xiyu0826/FaceAccess/hardware/原理图/01-全板原理图.png

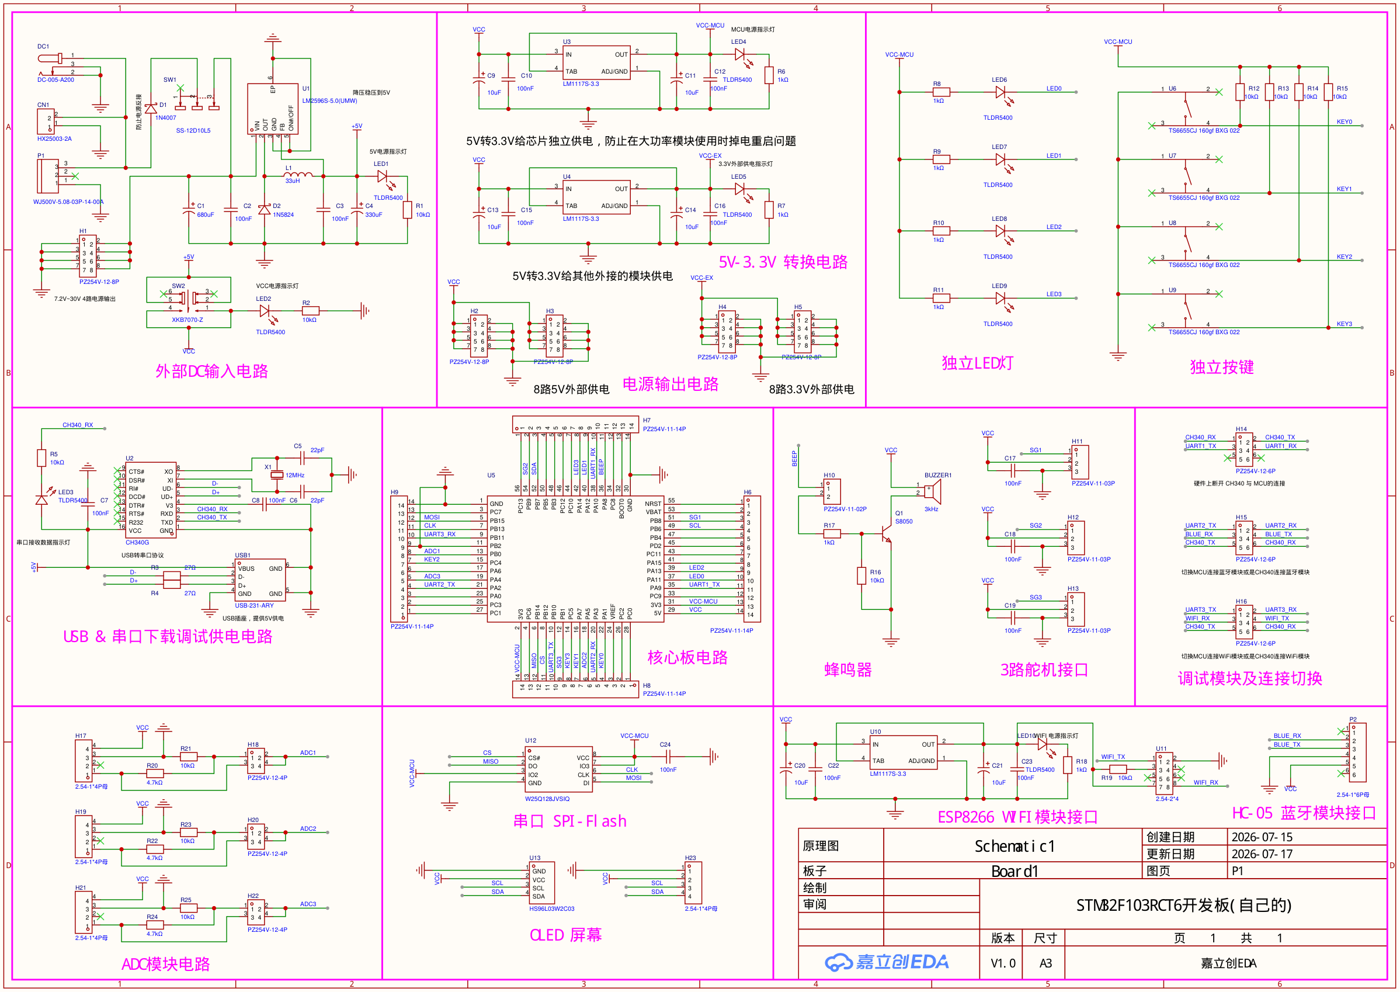
hardware/原理图/01-全板原理图.png
