xiyu0826/FaceAccess/hardware/原理图/02-核心板电路.png

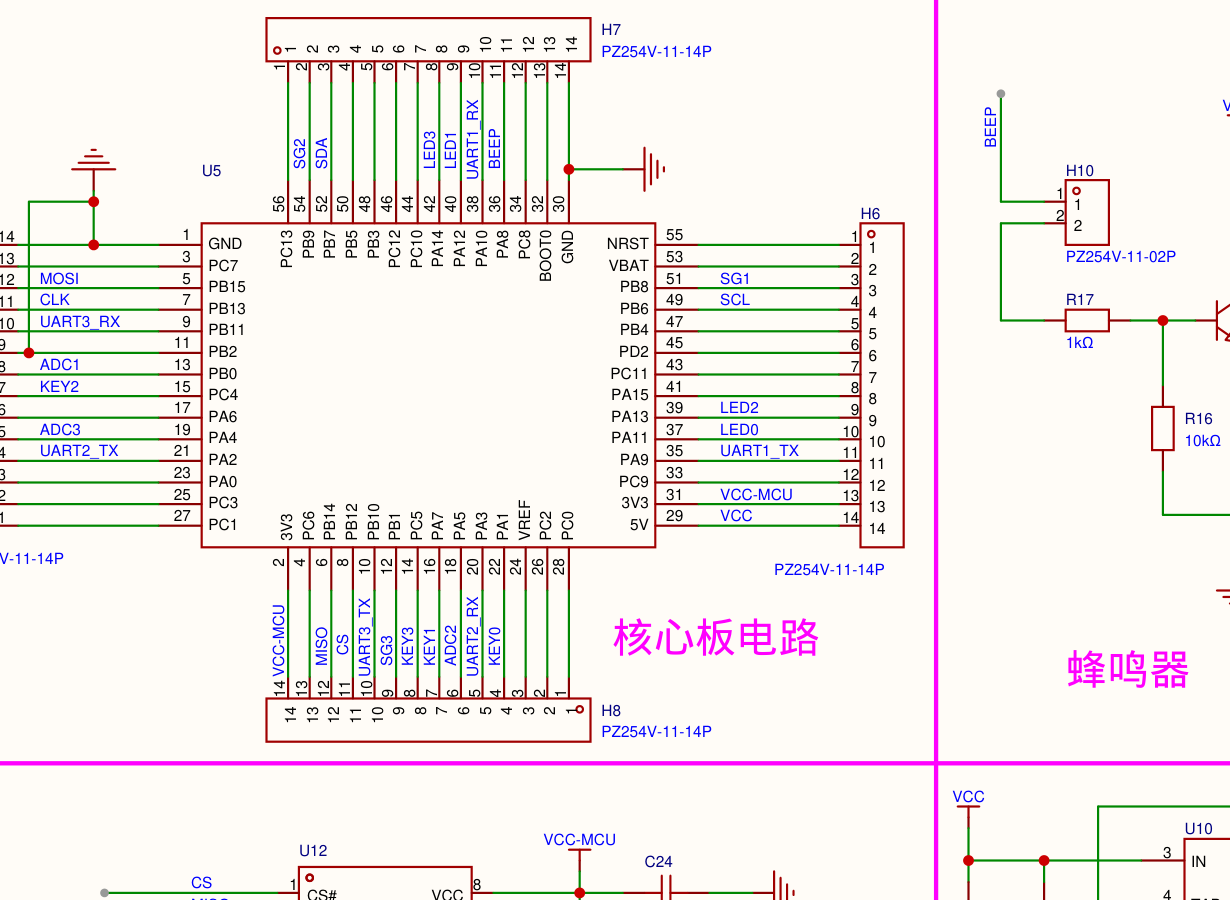
hardware/原理图/02-核心板电路.png
