xiyu0826/FaceAccess/hardware/原理图/03-核心板与H9排针.png

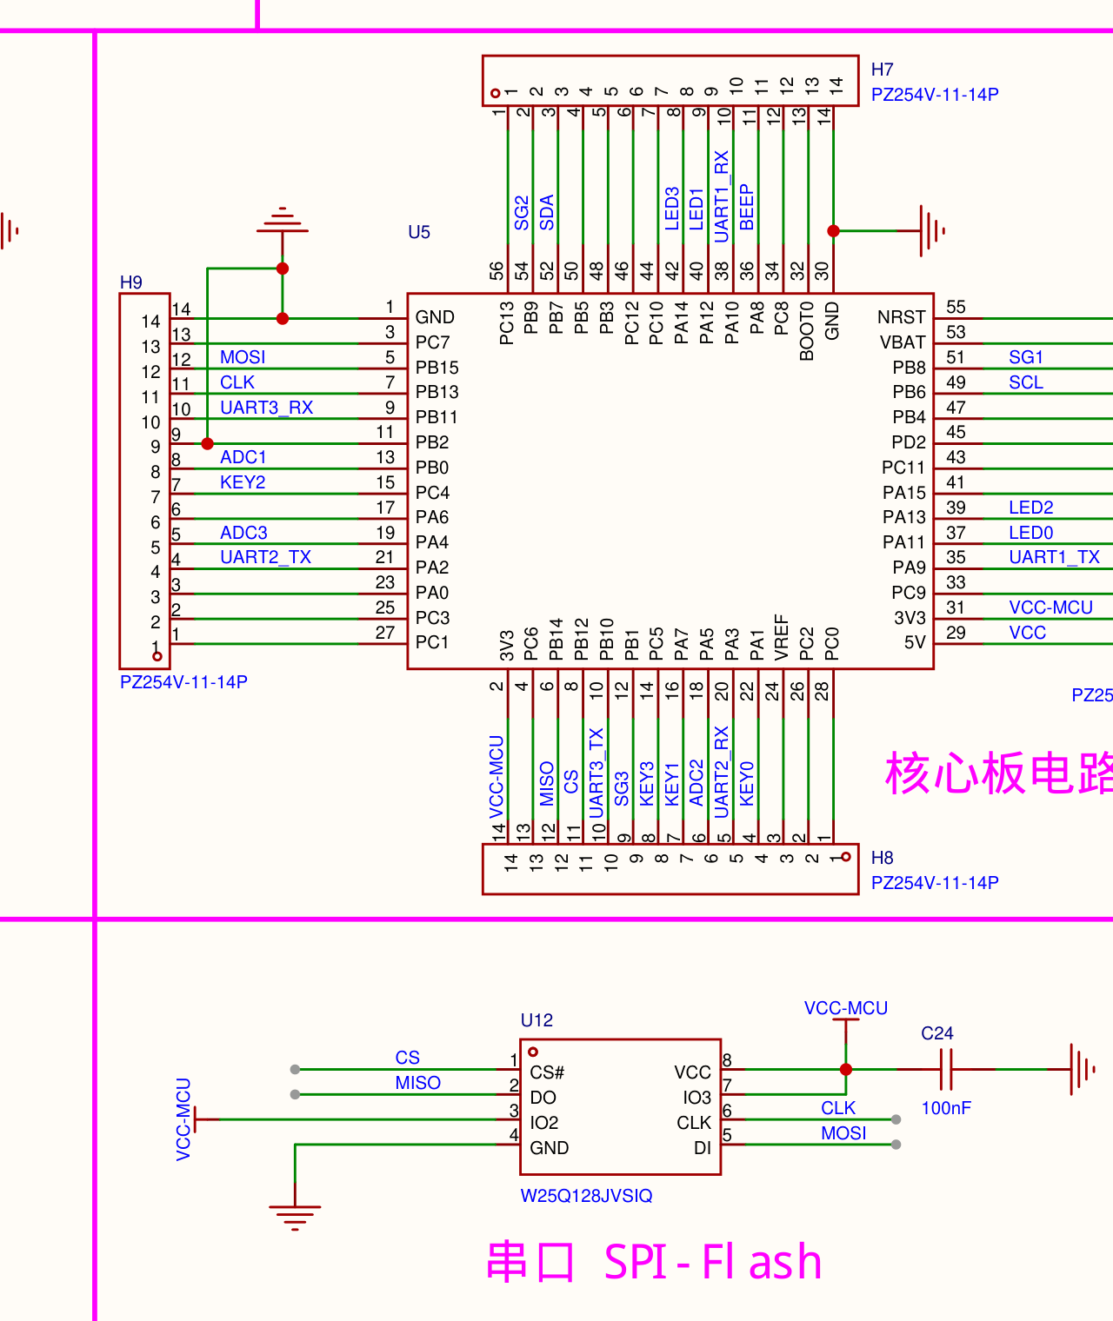
hardware/原理图/03-核心板与H9排针.png
