xiyu0826/FaceAccess/hardware/原理图/04-核心板右侧与H6排针.png

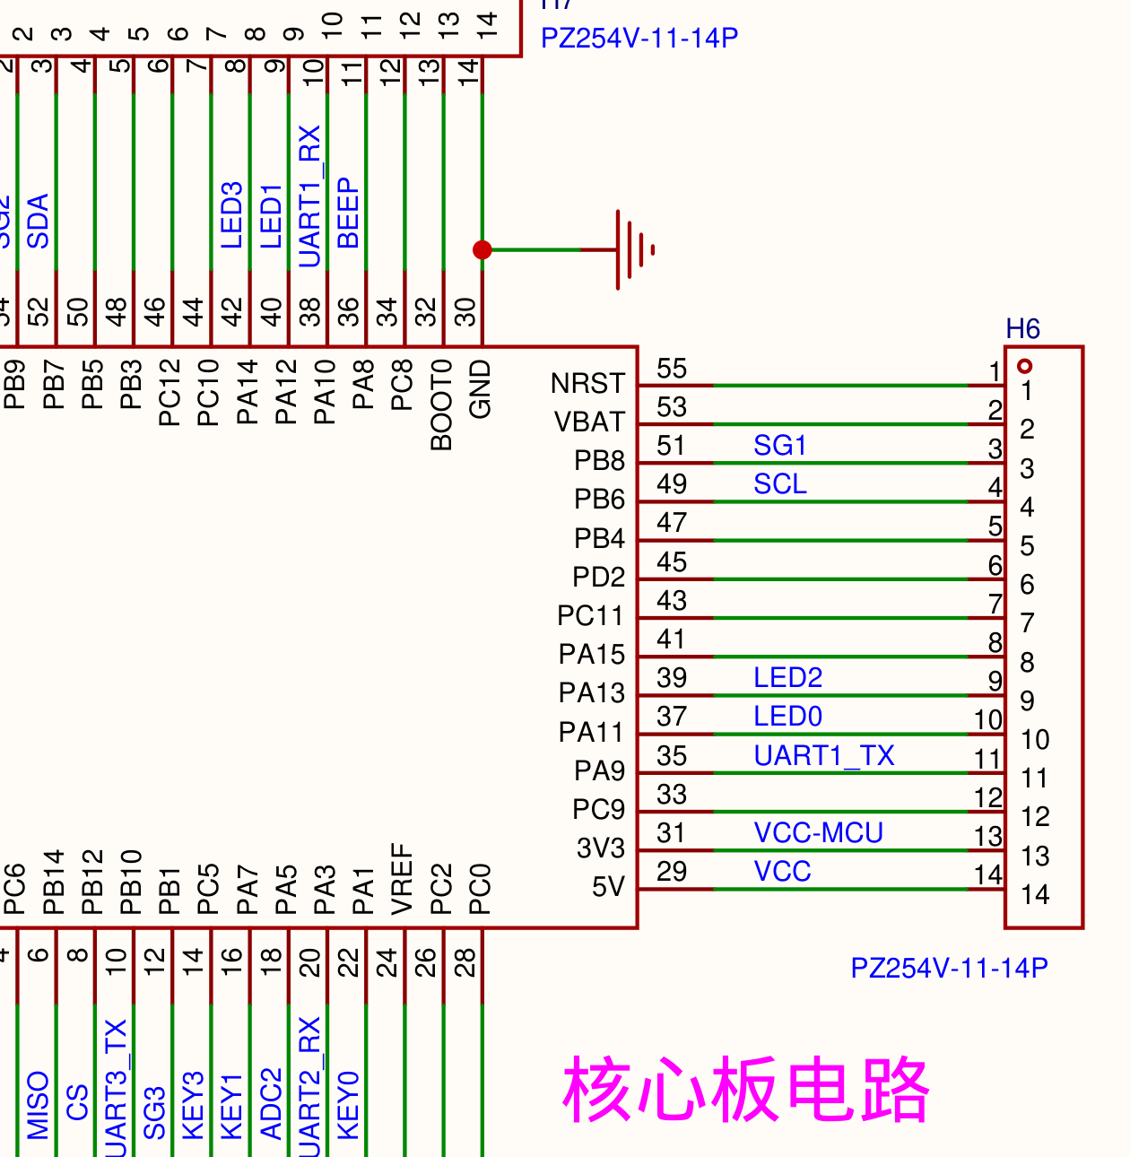
hardware/原理图/04-核心板右侧与H6排针.png
