xiyu0826/FaceAccess/hardware/原理图/05-外部晶振与USB供电.png

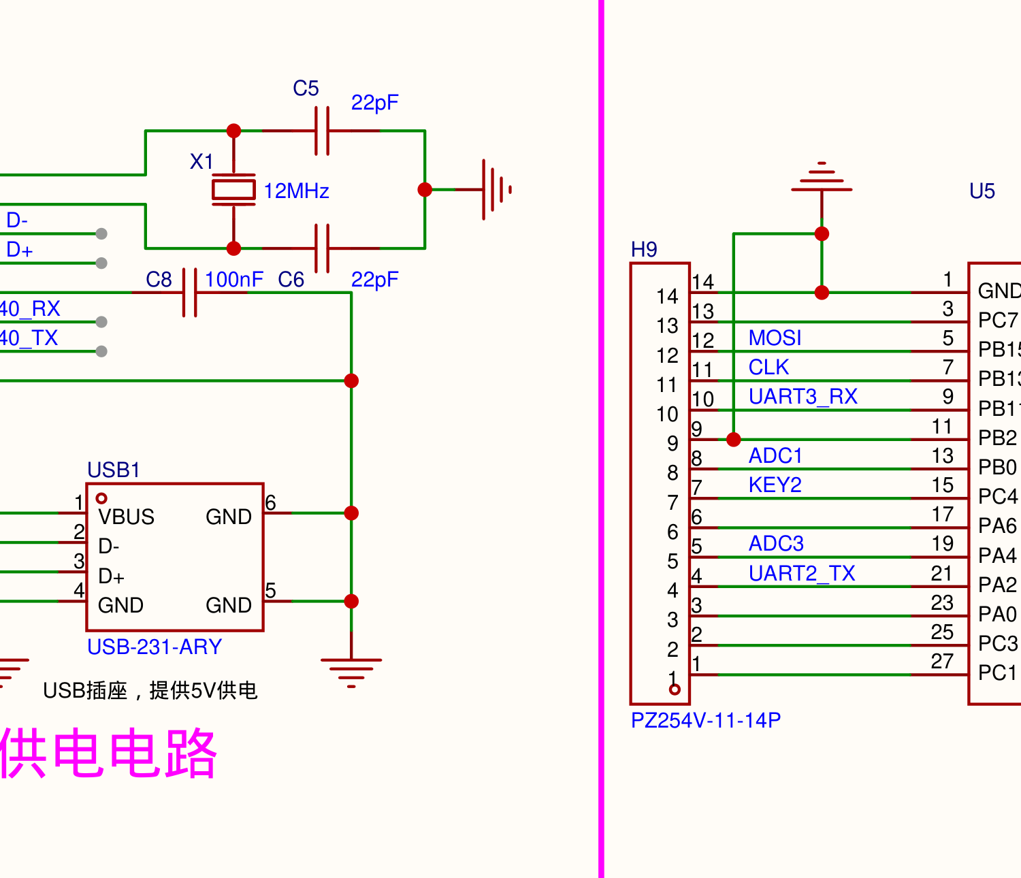
hardware/原理图/05-外部晶振与USB供电.png
