xiyu0826/FaceAccess/hardware/原理图/06-电源输出与8路5V供电.png

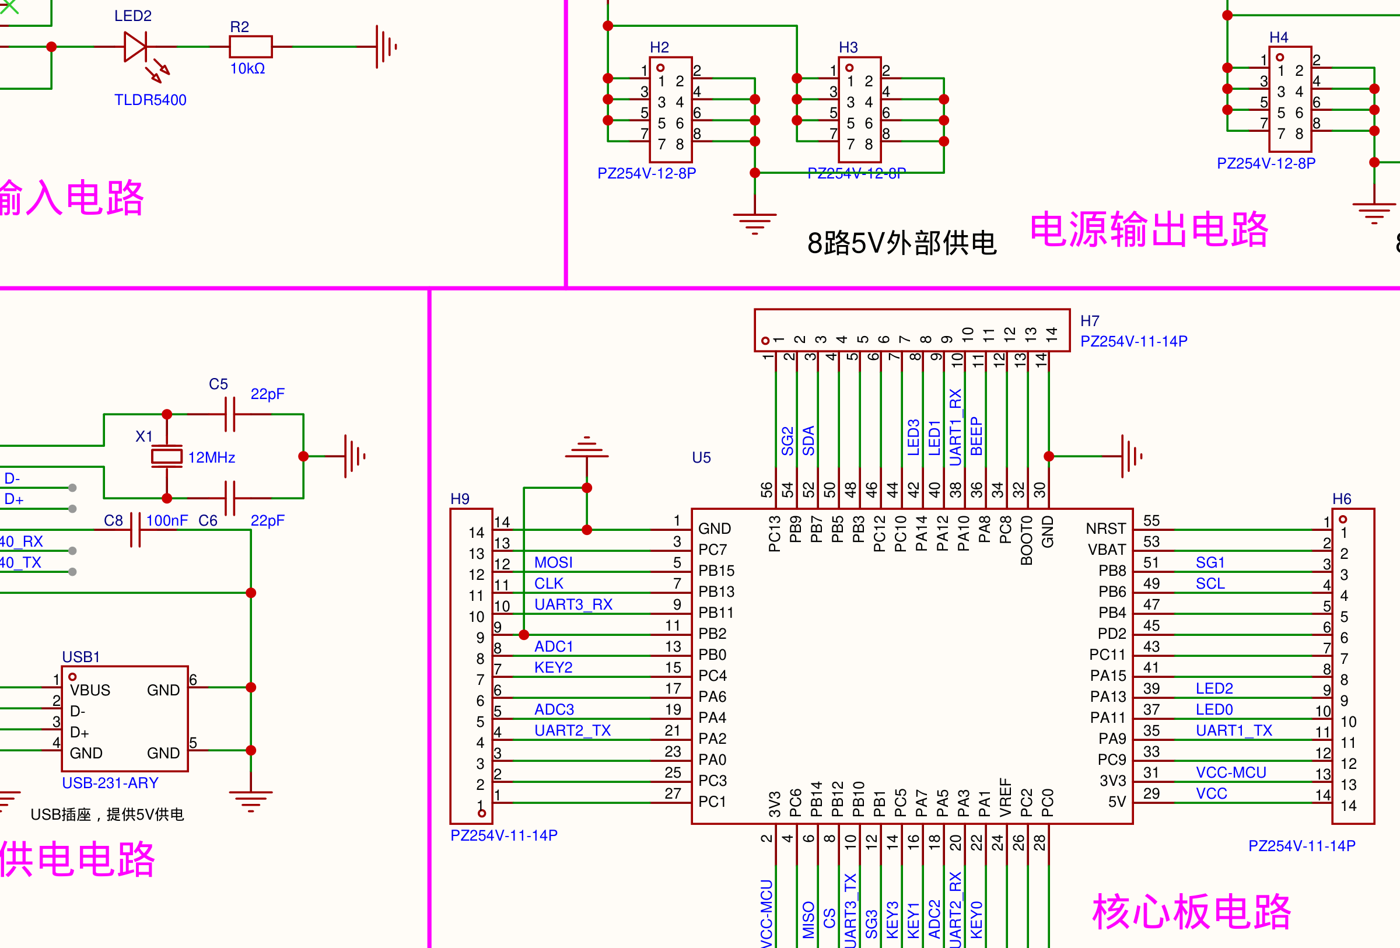
hardware/原理图/06-电源输出与8路5V供电.png
