xiyu0826/FaceAccess/hardware/原理图/07-独立LED与独立按键.png

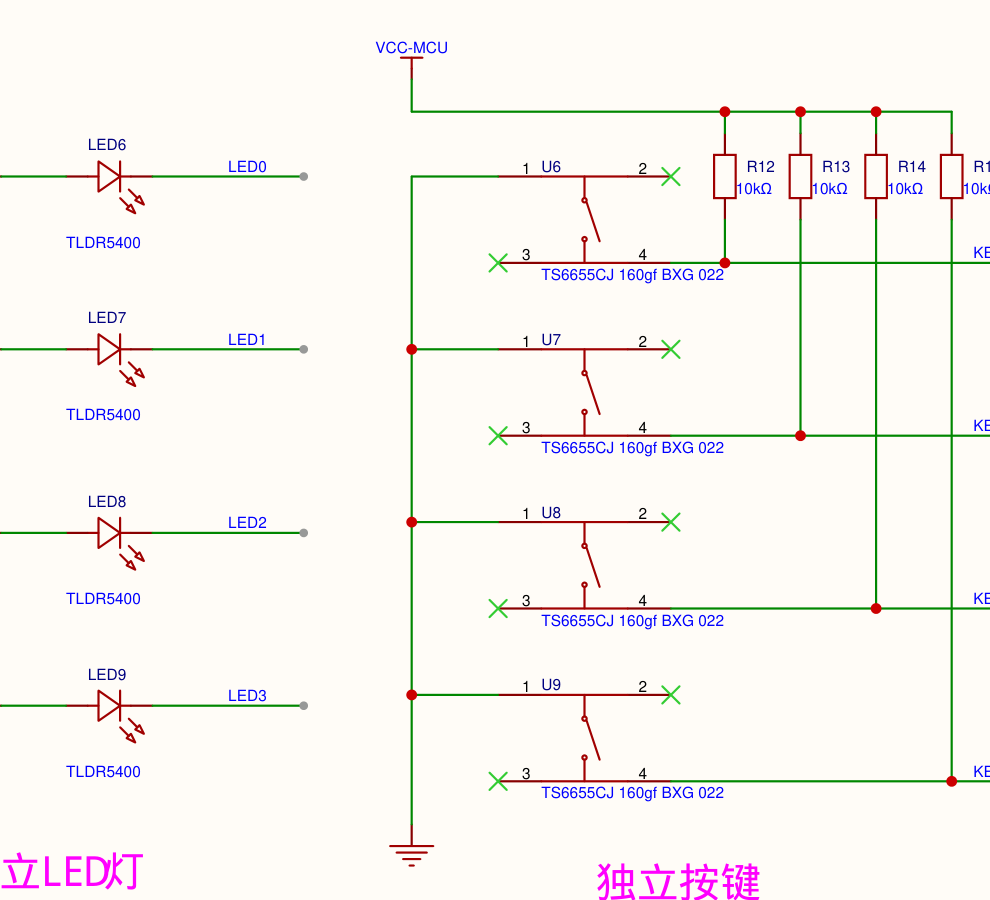
hardware/原理图/07-独立LED与独立按键.png
