xiyu0826/FaceAccess/hardware/原理图/08-串口SPI-Flash与H8排针.png

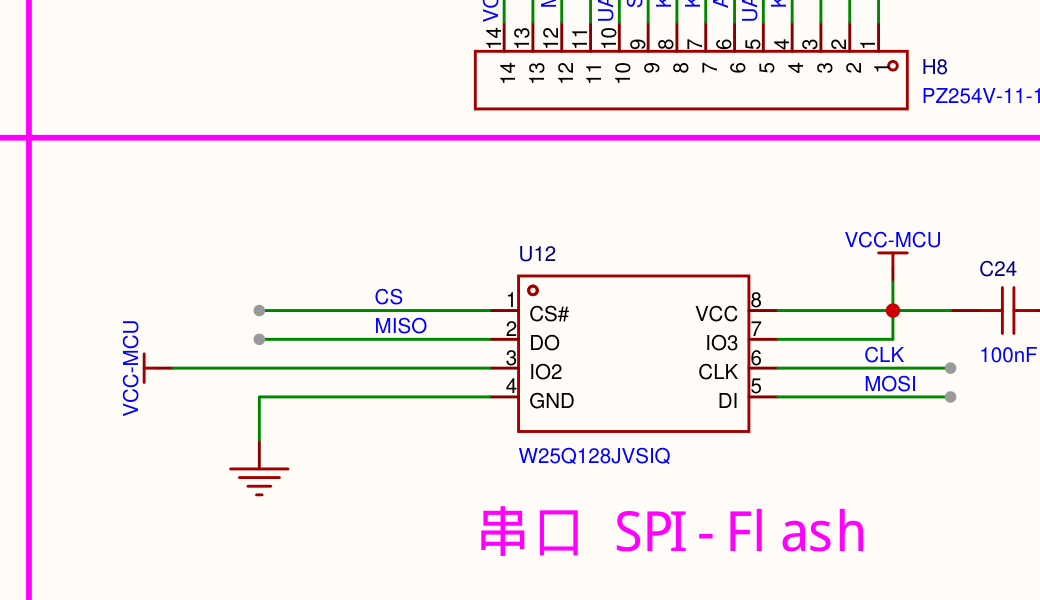
hardware/原理图/08-串口SPI-Flash与H8排针.png
