xiyu0826/FaceAccess/hardware/原理图/09-3路舵机接口.png

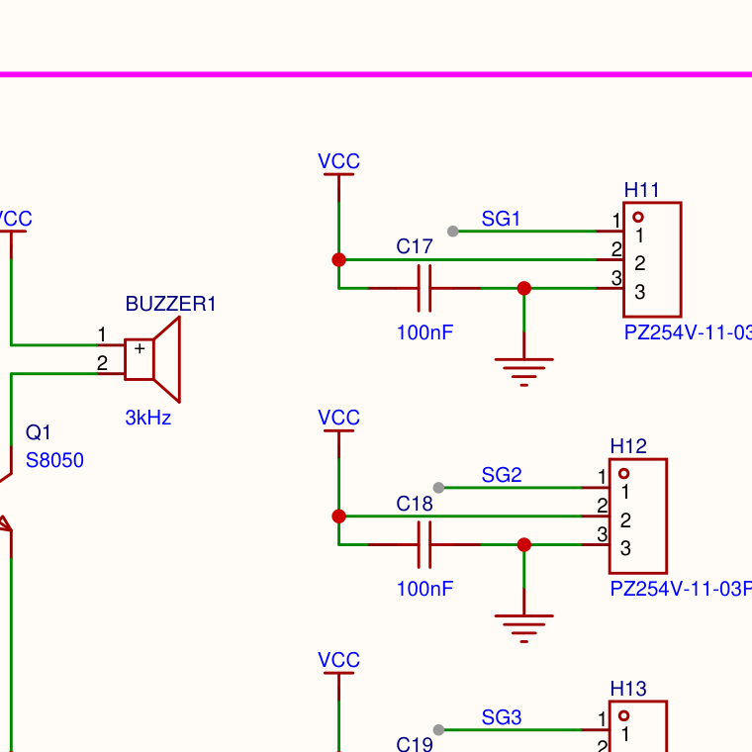
hardware/原理图/09-3路舵机接口.png
