xiyu0826/FaceAccess/hardware/原理图/10-蜂鸣器驱动.png

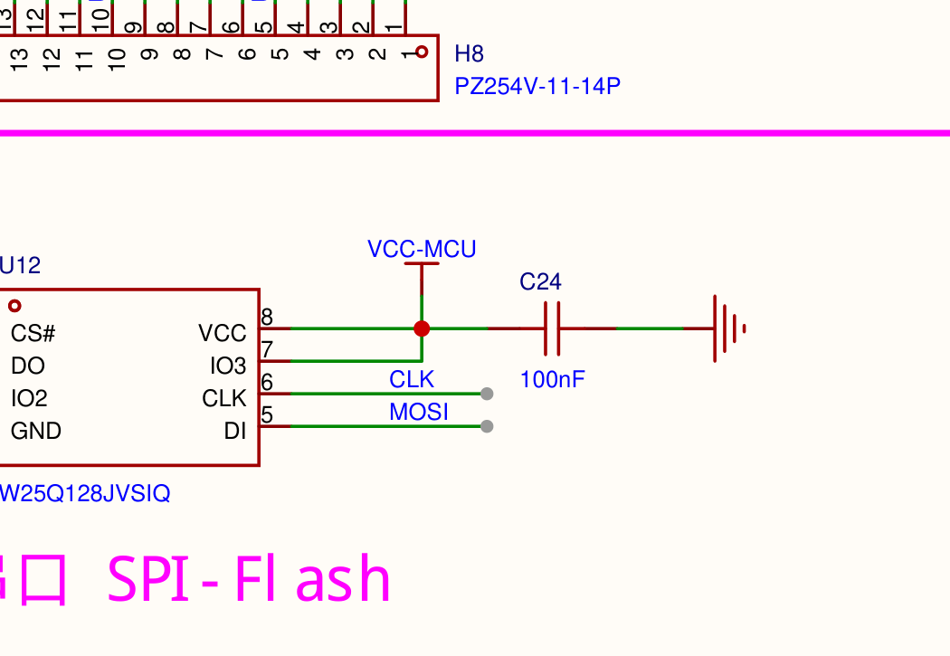
hardware/原理图/10-蜂鸣器驱动.png
