xiyu0826/FaceAccess/hardware/原理图/11-蜂鸣器接口H10.png

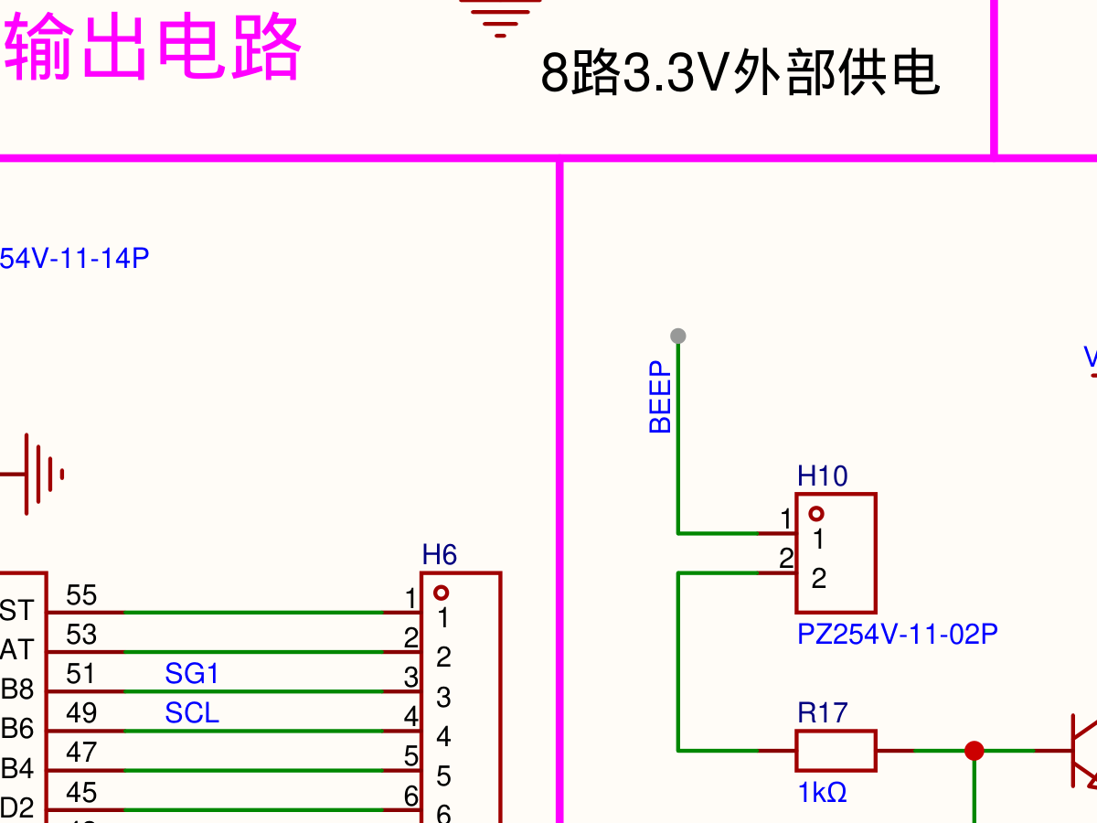
hardware/原理图/11-蜂鸣器接口H10.png
