xiyu0826/FaceAccess/hardware/原理图/12-ADC与无线模块接口.png

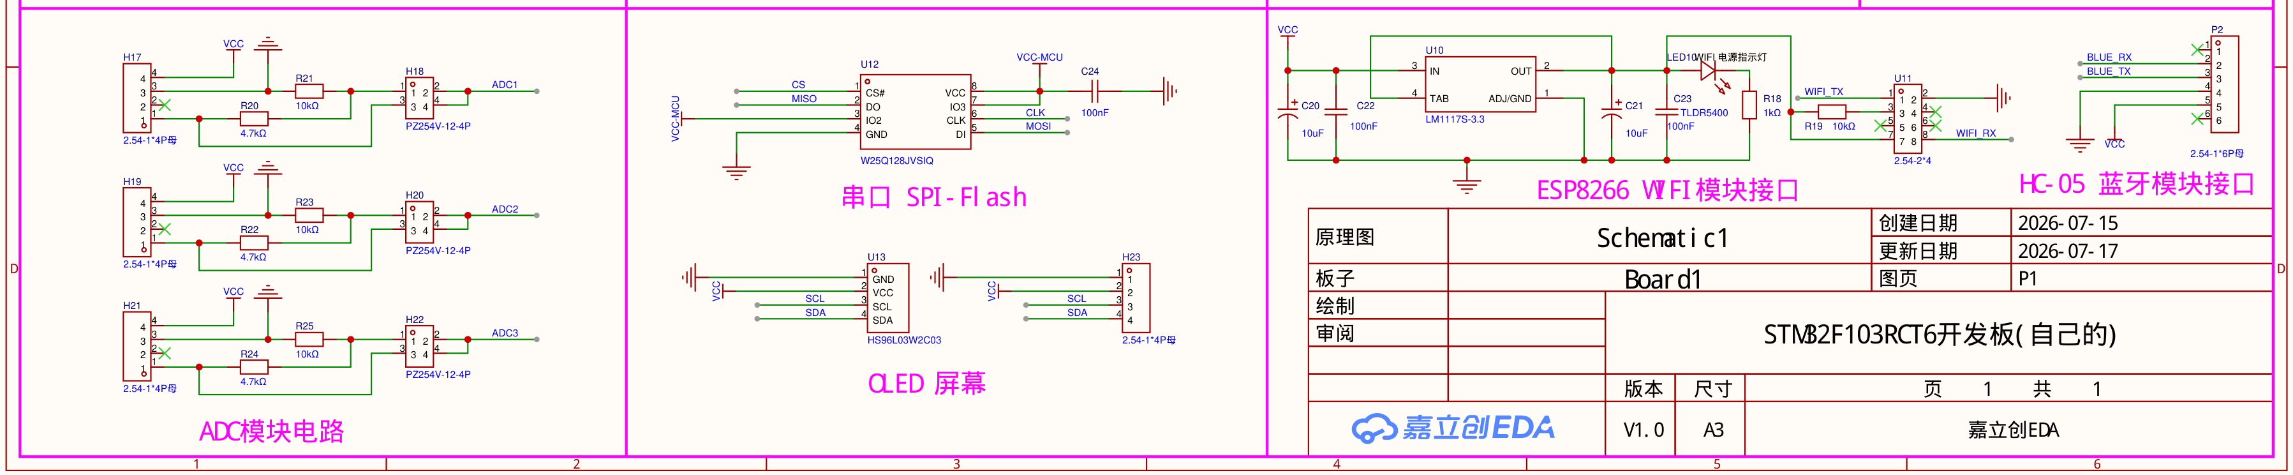
hardware/原理图/12-ADC与无线模块接口.png
