xiyu0826/FaceAccess/stm32/SYSTEM/chinese_font.h

#ifndef __CHINESE_FONT_H__
#define __CHINESE_FONT_H__

#include <stdint.h>

/*
 * 16x16 中文字库 (阴码: 0=亮笔画, 1=暗背景)
 * 每字 32 字节 = 16行 x 2字节, 逐行式/顺向(高位在前)
 * 使用: oled_show_chinese(x, y, CN_xxx)
 */

static const uint8_t cn_font[CN_COUNT][32] = {
    /* 0 温 */
    {0xFF,0xFF,0xDC,0x07,0xED,0xF7,0xED,0xF7,0x7C,0x07,0xBD,0xF7,0xBD,0xF7,0xEC,0x07,
     0xEF,0xFF,0xD8,0x03,0x1B,0x5B,0xDB,0x5B,0xDB,0x5B,0xDB,0x5B,0xD0,0x01,0xFF,0xFF},
    /* 1 湿 */
    {0xFF,0xFF,0xD8,0x07,0xEB,0xF7,0xEB,0xF7,0x78,0x07,0xBB,0xF7,0xBB,0xF7,0xE8,0x07,
     0xEE,0xDF,0xDE,0xDF,0x16,0xDB,0xDA,0xD7,0xDC,0xCF,0xDE,0xDF,0xD0,0x01,0xFF,0xFF},
    /* 2 度 */
    {0xFE,0xFF,0xFF,0x7F,0xC0,0x01,0xDD,0xDF,0xDD,0xDF,0xC0,0x03,0xDD,0xDF,0xDD,0xDF,
     0xDC,0x1F,0xDF,0xFF,0xD0,0x0F,0xDB,0xEF,0xBD,0xDF,0xBE,0x3F,0x79,0xCF,0xC7,0xF1},
    /* 3 空 */
    {0xFD,0xFF,0xFE,0xFF,0x80,0x01,0xBF,0xFD,0x77,0xDB,0xEF,0xEF,0xDF,0xF7,0xFF,0xFF,
     0xE0,0x0F,0xFE,0xFF,0xFE,0xFF,0xFE,0xFF,0xFE,0xFF,0xFE,0xFF,0x80,0x03,0xFF,0xFF},
    /* 4 气 */
    {0xEF,0xFF,0xEF,0xFF,0xC0,0x03,0xDF,0xFF,0xB0,0x0F,0x7F,0xFF,0xC0,0x0F,0xFF,0xEF,
     0xFF,0xEF,0xFF,0xEF,0xFF,0xEF,0xFF,0xEF,0xFF,0xF5,0xFF,0xF5,0xFF,0xF9,0xFF,0xFD},
    /* 5 质 */
    {0xFF,0x83,0xC0,0x3F,0xDF,0xBF,0xDF,0xBF,0xC0,0x01,0xDF,0xBF,0xDF,0xBF,0xD8,0x03,
     0xDB,0xFB,0xDB,0xBB,0xDB,0xBB,0xDB,0xBB,0xDB,0x4B,0xBE,0xF7,0xB9,0xFB,0x67,0xFD},
    /* 6 报 */
    {0xEF,0xFF,0xEE,0x03,0xEE,0xFB,0xEE,0xFB,0x02,0xEB,0xEE,0xF7,0xEE,0xFF,0xEA,0x03,
     0xE6,0xBB,0xCE,0xBB,0x2E,0xD7,0xEE,0xD7,0xEE,0xEF,0xEE,0xD7,0xAE,0xBB,0xDE,0x7D},
    /* 7 警 */
    {0xDB,0xDF,0x00,0xDF,0xDB,0x81,0x81,0x3B,0x7D,0xD7,0x85,0xEF,0xB5,0xD7,0x85,0x39,
     0xFA,0xFF,0x00,0x01,0xFF,0xFF,0xC0,0x07,0xFF,0xFF,0xC0,0x07,0xDF,0xF7,0xC0,0x07},
    /* 8 正 */
    {0xFF,0xFF,0x80,0x03,0xFE,0xFF,0xFE,0xFF,0xFE,0xFF,0xFE,0xFF,0xEE,0xFF,0xEE,0x07,
     0xEE,0xFF,0xEE,0xFF,0xEE,0xFF,0xEE,0xFF,0xEE,0xFF,0xEE,0xFF,0x00,0x01,0xFF,0xFF},
    /* 9 常 */
    {0xFE,0xFF,0xEE,0xEF,0xF6,0xDF,0x80,0x01,0xBF,0xFD,0x60,0x0B,0xEF,0xEF,0xE0,0x0F,
     0xFE,0xFF,0xC0,0x07,0xDE,0xF7,0xDE,0xF7,0xDE,0xD7,0xDE,0xEF,0xFE,0xFF,0xFE,0xFF},
    /* 10 智 */
    {0xDF,0xFF,0xC1,0x83,0xB7,0xBB,0xF7,0xBB,0x00,0xBB,0xEB,0xBB,0xDD,0x83,0xBF,0xFF,
     0xE0,0x0F,0xEF,0xEF,0xEF,0xEF,0xE0,0x0F,0xEF,0xEF,0xEF,0xEF,0xE0,0x0F,0xEF,0xEF},
    /* 11 能 */
    {0xEF,0xBF,0xDB,0xBB,0xBD,0xB7,0x00,0x8F,0xFE,0xBF,0xFF,0xBD,0x81,0xBD,0xBD,0xC1,
     0xBD,0xFF,0x81,0xBB,0xBD,0xB7,0xBD,0x8F,0x81,0xBF,0xBD,0xBD,0xB5,0xBD,0xBB,0xC1},
    /* 12 家 */
    {0xFD,0xFF,0xFE,0xFF,0x80,0x01,0xBF,0xFD,0x7F,0xFB,0x80,0x03,0xFD,0xFF,0xF2,0xF7,
     0x8E,0x6F,0xFD,0x5F,0xF3,0x3F,0x8E,0x5F,0xF9,0x67,0xE7,0x79,0x1D,0x7F,0xFE,0xFF},
    /* 13 居 */
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
};

#endif
