xiyu0826/FaceAccess/(commit log)

2026-10-12 chore: 初始化仓库，添加 .gitignore 与 .gitattributes
2026-10-12 feat: 添加 STM32 基础库（CMSIS / HAL / FreeRTOS）
2026-10-12 feat: 添加板级外设驱动（舵机 / 门禁 / OLED / 传感器 / WiFi / MQTT）
2026-10-12 feat: 添加智能家居主工程（FreeRTOS 六个任务）
2026-10-12 feat: 添加板级自检与外设测试工程
2026-10-12 feat: 添加 Qt 上位机（OpenCV 人脸识别 + SQLite + 串口）
2026-10-12 feat: 添加 MQTT 网页看板（Flask + paho-mqtt）
2026-10-12 feat: 添加开发板原理图
2026-10-12 docs: 添加 README 与设计说明
2026-10-12 fix: 界面按钮文案改为「开锁记录」
2026-10-12 style: 统一界面文案与注释为「保险柜 / 开锁」语境
2026-10-12 chore: 标记厂商代码为 vendored，修正 GitHub 语言统计
2026-10-13 style: 网页看板文案统一为保险柜口径
    看板标题原为「智能家居环境监控」，与项目形态不符，改为
    「人脸保险柜状态监控」；同步修正页面 title 与文件头注释。
    设计说明里「复用智能家居固件」改为「复用 STM32 实训固件」。
2026-10-13 docs: 补充运行截图与开锁演示视频
    加入 Qt 上位机主界面、录入人员、开锁记录查询、网页看板四张
    运行截图，以及手机实拍的开锁演示视频，README 增加「运行效果」
    章节。截图已裁去窗口标题栏。
